AddictedBoy/Development-of-Locker-System-using-Fingerprint-Sensor-Face-Recognition/README.md

# Development-of-Locker-System-using-Fingerprint-Sensor-Face-Recognition
Repository for 2022/2023 Final Year Project
