AddictedBoy/Development-of-Locker-System-using-Fingerprint-Sensor-Face-Recognition/Assembly.FCStd

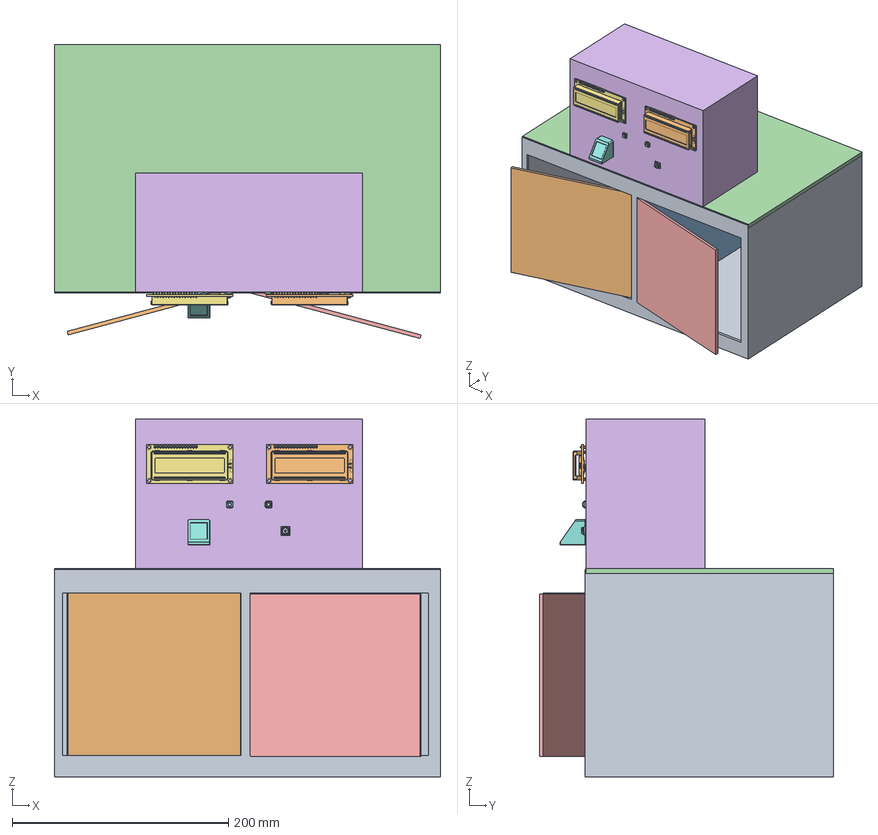
[picture p53: CAD file, 2023-07-27]
Assembly.FCStd
357.0 x 272.0 x 331.0 mm
LCD001
Fingerprint Reader
ESP3-CAM v005
LCD002
